jesrockr/stm32_f9p_gnss_base_logger/assets/stm32-board-back.jpg

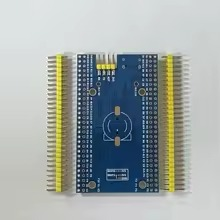
assets/stm32-board-back.jpg
