jesrockr/stm32_f9p_gnss_base_logger/README.md

# STM32 F9P GNSS Data Logger

Low-cost STM32-based raw GNSS datalogger for u-blox ZED-F9P receivers. The logger records a raw UBX stream to an SD card for later PPK processing and transmits RTCM corrections for RTK FIX with rover, while a small OLED displays live write status, file name, fix state, satellite count, UTC time, and various warnings.

## What It Does

- Logs the incoming F9P UBX byte stream directly to SD card.
- Creates incrementing files such as `GNSS001.UBX`, `GNSS002.UBX`, and so on.
- Uses UART DMA circular buffering to reduce packet loss risk.
- Displays SD write status and overrun warnings on OLED.
- Parses `UBX-NAV-PVT` passively for `UTC time`, `fix type`, and `satellite count` live display.
- Uses GNSS `UTC time` for FatFS file timestamps once valid time is available.
- Appears as USB Storage device on Windows through STM32 usb type c port.
  
## Hardware Used:

## STM32F407ZGT6 Board
[cost: $14.60](https://www.aliexpress.us/item/3256809863003361.html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)

STM32

## SSD1306 OLED
[cost: $2.60](https://www.aliexpress.us/item/3256805954920554.html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)

SSD1306 OLED module

## ZED-F9P-01B-01 GNSS 
[cost: $103.62](https://www.aliexpress.us/item/3256806049727804.html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)

ZED-F9P module

## Holybro Sik Radio (optional)

[cost: $89.00](https://www.aliexpress.us/item/3256812345612252.html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)

Sik Radio

## ST LINK V2

[cost: $2.99](https://www.aliexpress.us/item/3256807158603766.html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)

ST LINK V2

## Prerequisites

Download the [latest .elf](https://github.com/jesrockr/stm32_f9p_gnss_base_logger/releases/tag/v1.0.0)

Install the STM32 development tools from STMicroelectronics:

- STM32CubeProgrammer
- STM32CubeMX (optional)
- STM32CubeIDE (optional)

Download them from the official ST website:

https://www.st.com/en/development-tools/stm32-software-development-tools.html

Install u-blox u-center for configuring and testing the ZED-F9P:

- u-center GNSS evaluation software

Download from u-blox:

https://www.u-blox.com/en/product/u-center

Recommended workflow:

- Use STM32CubeProgrammer to flash the .ELF file to the STM32 board.
- `NOTE: BOOT0 jumper must be soldered in order to flash board (via usb type-c), then unsoldered to run program. Recommend install of a switch or two wires to simplify multiple flashes of board. Alternatively, an ST-Link V2 module can be used to flash the board through the debug pins "DIO, CLK, GND, 3v3"`
- Use FAT32 formatted SD card inserted into onboard STM32 slot.
- Use u-center to configure the F9P output messages and verify `.UBX` log playback.

## QUICK START

- [Wiring Diagram](assets/BASEWIRINGDIAGRAM.png)
- [Build and Flash](docs/BUILD_AND_FLASH.md)
- [F9P Configuration](docs/F9P_CONFIGURATION.md)

## Recommended F9P Output Messages

For PPK logging, enable on `UART 1` (or whichever F9P `PORT` is connected to STM32 `Rx` pin):

- `UBX-RXM-RAWX`
- `UBX-RXM-SFRBX`
- `UBX-NAV-PVT` at 1 Hz
- `UBX-NAV-SVIN` at 1 Hz

Optional:

- `UBX-NAV-SAT` at 1 Hz for richer satellite diagnostics

Disable unnecessary `NMEA` and high-rate navigation messages unless you have confirmed the UART and SD write pipeline have enough bandwidth.

## OLED Logging Screen

Typical boot up / logging screen:

boot screen

logging screen

Warnings:

- `WARNING OVERRUN`: UART receive/write pipeline fell behind. The log may have dropped bytes.
- `NO GNSS DATA`: no recent valid `NAV-PVT` packet has been parsed.
- Fix type flashes if the solution is not acceptable for PPK.
- `SURVEYING IN` flashes until base position is `SURVEY IN OK`.
- `TIME` is the standard fix type once position is surveyed-in.
- If `SAT=0` and `NO FIX`, check antenna.

## Important Reliability Notes

- For PPK, dropped bytes matter. Watch `WARNING OVERRUN`.
- Use a good SD card and avoid removing power before writes are synced.
- Keep unnecessary f9p receiver messages disabled. We want bandwidth to remain as lean as possible.
- Confirm logged `.UBX` files open correctly in u-center before relying on field data.
- Long-duration testing is strongly recommended before survey use.

## TMODE3 (BASE COORDINATE CONFIGURATION)

You are able to set this base up on known coordinates (`FIXED`, more repeatable but requires known LAT/LONG/ELEV and ANTENNA HEIGHT) or `SURVEY-IN` your position (requires you to set minimum observation time and minimum accuracy in meters). These can be changed in Ucenter under VIEW-CONFIGURATION VIEW-TMODE3. 
You are also able to change TMODE3 by creating a BASE.TXT file on the SD card in the STM32, with the following text format:

## SURVEY-IN (add this to the BASE.TXT on sd card)
```
MODE=SURVEY_IN

SVIN_MIN_DUR_S=600

SVIN_ACC_M=0.7
```
### OR
## FIXED (add this to the BASE.TXT on sd card)
```
MODE=FIXED

LAT=37.1234568

LON=-121.1234568

MARK_ELEV_M=100.000

ANTENNA_HEIGHT_M=2.000

FIXED_ACC_M=0.020
```
The STM32 will read this textfile upon boot and send a command to the F9P.
