jesrockr/stm32_f9p_gnss_base_logger/assets/BASE WIRING DIAGRAM.png

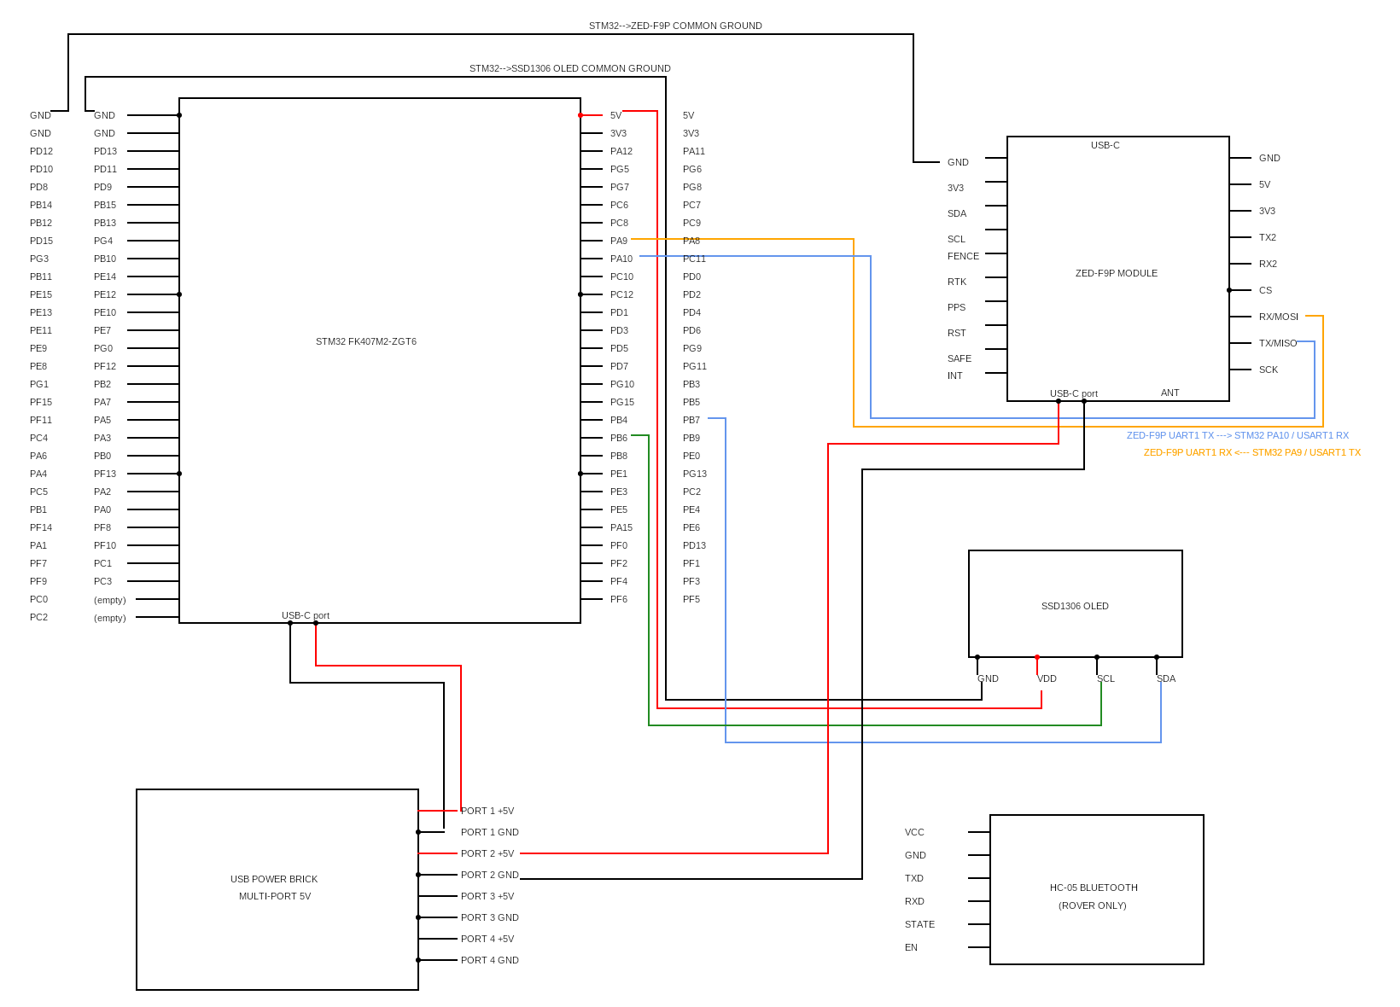
assets/BASE WIRING DIAGRAM.png
