jesrockr/stm32_f9p_gnss_base_logger/TODO.md

# TODO

## Eventually

- Add exact board wiring table.
- Add photos of the assembled logger.
- Add u-center screenshots or step-by-step F9P config export.
- Add build/import instructions for STM32CubeIDE.
- Add SD card formatting recommendation.
- Add tested file playback workflow in u-center.
- Add long-duration logging test results.

## Nice-To-Have Improvements

- Export a known-good F9P configuration file.
- Add optional external button wiring diagram.
- Add case/enclosure notes.
- Add power consumption notes.
- Add PPK processing example workflow.
