jesrockr/stm32_f9p_gnss_base_logger/STM32_GNSS_BASE.ioc

Mcu.UserName=STM32F407ZGTx
PA10.Signal=USART1_RX
PA11.Signal=USB_OTG_FS_DM
PA12.Signal=USB_OTG_FS_DP
PA9.Signal=USART1_TX
PB6.Signal=I2C1_SCL
PB7.Signal=I2C1_SDA
PC10.Signal=SDIO_D2
PC11.Signal=SDIO_D3
PC12.Signal=SDIO_CK
PC8.Signal=SDIO_D0
PC9.Signal=SDIO_D1
PD2.Signal=SDIO_CMD
