jesrockr/stm32_f9p_gnss_base_logger/(commit log)

2026-06-05 Add files via upload
    Removed push-button functionality, as the rover program now handles start/stop and storing points via momentary switch. Irrelevant for base logging purposes.
2026-06-18 Delete Core/Src/main.c
    UPDATED to include an option for TMODE3 control via a file created on the SD card called BASE.TXT which includes base mode and accuracy settings OR fixed coordinates.
    FIXED is for when you want to set up on a repeatable or static point with known coordinates
    SURVEY-IN is for a first-time non-repeatable (unless you run OPUS) averaged base position
    [main.c]
2026-08-15 Update README.md
    only CUBE programmer is necessary to flash .ELF onto the board
